hazy2go/gb-link-usb/hw/rev-a/fab/bom_check.txt

BOM check for 5 boards: 27 lines, 57 placed parts, 10 extended parts (feeder fee each), DNP: R1

ok   C15850    base   stock   3657249 need   20  10u                C1,C5,C19                                CL21A106KAYNNNE        
ok   C1525     base   stock  22403876 need   60  100n               C2,C8,C10,C11,C12,C13,C14,C15,C16,C17,C1 CL05B104KO5NNNC        
ok   C1548     base   stock   1209694 need   15  15p                C3,C4                                    0402CG150J500NT        
ok   C23733    base   stock   1859380 need   15  4.7u               C6,C7                                    CL05A475MP5NRNC        
ok   C23733    base   stock   1859380 need   10  4.7u               C9                                       CL05A475MP5NRNC        
ok   C1525     base   stock  22403876 need   35  100n               C101,C102,C103,C104,C105,C106            CL05B104KO5NNNC        
ok   C1546     base   stock   3945135 need   15  100p               C107,C108                                0402CG101J500NT        
ok   C2297     base   stock   2716005 need   10  green              D101                                     KT-0805G               
ok   C165948   expand stock    379998 need   10  TYPE-C-31-M-12     J101                                     TYPE-C-31-M-12         
FAIL C42411119 expand stock         9 need   10  AOTA-B201610S3R3-1 L1                                       AOTA-B201610S3R3-101-T STOCK 9 < 10
ok   C11702    base   stock  14390861 need   20  1k                 R2,R4,R6                                 0402WGF1001TCE         
ok   C25105    base   stock   1423784 need   10  33                 R3                                       0402WGF330JTCE         
ok   C25100    expand stock     33133 need   15  27                 R7,R8                                    0402WGF270JTCE         
ok   C17168    base   stock   9266226 need   10  0                  R10                                      0402WGF0000TCE         
ok   C25905    base   stock   5299091 need   15  5.1k               R101,R102                                0402WGF5101TCE         
ok   C25741    base   stock   9728792 need   20  100k               R103,R107,R108                           0402WGF1003TCE         
ok   C25091    base   stock   1296840 need   15  220                R104,R105                                0402WGF2200TCE         
ok   C11702    base   stock  14390861 need   10  1k                 R106                                     0402WGF1001TCE         
ok   C25076    base   stock   8294192 need   10  100                R109                                     0402WGF1000TCE         
ok   C115360   expand stock     33840 need   15  SKRPABE010         SW1,SW2                                  SKRPABE010             
ok   C42411118 expand stock      6312 need   10  RP2350A            U1                                       RP2350A                
ok   C26537    expand stock     61140 need   10  NCP1117ST33T3G     U2                                       NCP1117ST33T3G         
ok   C97521    base   stock     66926 need   10  W25Q128JVSIQ       U3                                       W25Q128JVSIQ           
ok   C7519     expand stock     48218 need   10  USBLC6-2SC6        U101                                     USBLC6-2SC6            
ok   C7843     expand stock    348745 need   20  SN74LVC1T45DBVR    U102,U103,U104                           SN74LVC1T45DBVR        
ok   C138714   expand stock    247062 need   10  TPD4E05U06DQAR     U105                                     TPD4E05U06DQAR         
ok   C20625731 expand stock      6186 need   10  ABM8-272-T3        X1                                       ABM8-272-T3            

RESULT: 1 FAIL
