hazy2go/gb-link-usb/hw/rev-a/fab/gb-link-usb-BOM-JLC.csv

Comment | Designator | Footprint | LCSC Part #
10u | C1,C5,C19 | generic_capc2012x125 | C15850
100n | C2,C8,C10,C11,C12,C13,C14,C15,C16,C17,C18 | generic_capc1005x50 | C1525
15p | C3,C4 | generic_capc1005x50 | C1548
4.7u | C6,C7 | generic_capc1005x50_wide | C23733
4.7u | C9 | generic_capc1005x50 | C23733
100n | C101,C102,C103,C104,C105,C106 | C_0402_1005Metric | C1525
green | D101 | LED_0805_2012Metric | C2297
TYPE-C-31-M-12 | J101 | USB_C_Receptacle_HRO_TYPE-C-31-M-12 | C165948
AOTA-B201610S3R3-101-T | L1 | abracon_aota-b201610s3r3-101-t | C42411119
1k | R2,R4,R6 | generic_resc1005x35 | C11702
33 | R3 | generic_resc1005x35 | C25105
27 | R7,R8 | generic_resc1005x35 | C25100
0 | R10 | generic_resc1005x35 | C17168
5.1k | R101,R102 | R_0402_1005Metric | C25905
100k | R103,R107,R108 | R_0402_1005Metric | C25741
33 | R104,R105,R106 | R_0402_1005Metric | C25105
100 | R109 | R_0402_1005Metric | C25076
SKRPABE010 | SW1,SW2 | wurthelek_434133025816 | C115360
RP2350A | U1 | rpi_rp2350a_vias | C42411118
NCP1117ST33T3G | U2 | onsemi_ncp1117st33t3g | C26537
W25Q128JVSIQ | U3 | generic_soic127p790x195-8 | C97521
USBLC6-2SC6 | U101 | SOT-23-6 | C7519
SN74LVC1T45DBVR | U102,U103,U104 | SOT-23-6 | C7843
TPD4E05U06DQAR | U105 | USON-10_2.5x1.0mm_P0.5mm | C138714
ABM8-272-T3 | X1 | generic_xtalcc320x250x80-4 | C20625731
