hazy2go/gb-link-usb/hw/case/tray.stl

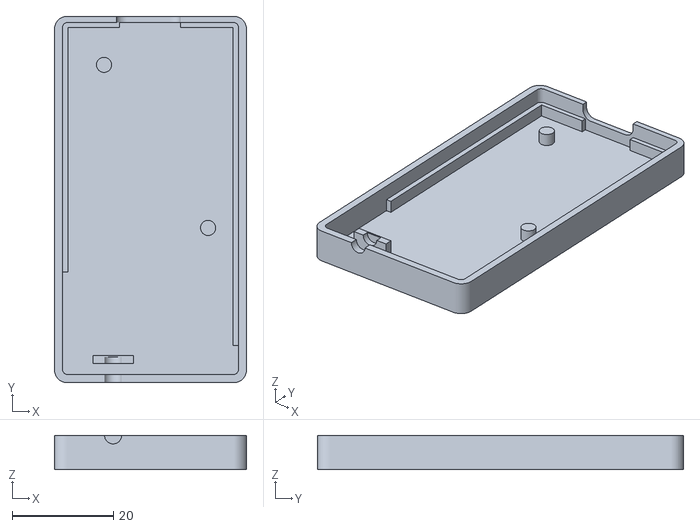
[picture p8: CAD file, 2026-10-15]
hw/case/tray.stl
38.0 x 72.5 x 6.80
