hazy2go/gb-link-usb/hw/case/parts.scad

module parts_top() {
  // generated by check_fit.py: every top part as a box (courtyard x height), board-local coordinates
  translate([24.720,41.070,0]) cube([2.010,1.260,1.300]); // C5
  translate([9.710,29.045,0]) cube([1.010,0.510,0.500]); // C15
  translate([12.380,47.615,0]) cube([1.010,0.510,0.500]); // C2
  translate([21.445,44.095,0]) cube([6.510,7.260,1.800]); // U2
  translate([5.795,40.780,0]) cube([7.910,5.290,2.000]); // U3
  translate([14.345,37.595,0]) cube([0.510,1.010,0.500]); // C12
  translate([23.280,30.045,0]) cube([1.010,0.510,0.500]); // C14
  translate([21.880,26.445,0]) cube([1.010,0.510,0.500]); // C16
  translate([15.345,37.595,0]) cube([0.510,1.010,0.350]); // R7
  translate([23.633,53.570,0]) cube([2.010,1.260,1.300]); // C1
  translate([9.710,33.845,0]) cube([1.010,0.510,0.500]); // C13
  translate([16.345,37.595,0]) cube([0.510,1.010,0.350]); // R8
  translate([22.680,33.445,0]) cube([1.010,0.510,0.500]); // C17
  translate([0.810,52.070,0]) cube([2.010,1.260,1.300]); // C19
  translate([18.195,35.995,0]) cube([1.010,0.510,0.500]); // C7
  translate([17.595,36.995,0]) cube([2.210,1.810,1.000]); // L1
  translate([20.645,35.245,0]) cube([0.510,1.010,0.500]); // C9
  translate([31.845,21.095,0]) cube([0.510,1.010,0.350]); // R4
  translate([3.725,21.285,0]) cube([1.950,1.030,0.350]); // R105
  translate([6.295,53.195,0]) cube([3.210,4.610,2.500]); // SW1
  translate([29.175,27.705,0]) cube([3.450,1.990,1.100]); // D101
  translate([3.725,19.885,0]) cube([1.950,1.030,0.350]); // R108
  translate([11.185,52.325,0]) cube([1.030,1.950,0.350]); // R102
  translate([5.795,14.145,0]) cube([1.010,1.910,0.500]); // C106
  translate([7.405,19.155,0]) cube([4.190,3.490,1.550]); // U103
  translate([7.405,24.155,0]) cube([4.190,3.490,1.550]); // U102
  translate([7.405,14.155,0]) cube([4.190,3.490,1.550]); // U104
  translate([3.725,16.285,0]) cube([1.950,1.030,0.350]); // R106
  translate([0.205,1.555,0]) cube([19.040,11.940,0.050]); // J102
  translate([20.645,37.095,0]) cube([0.510,1.010,0.350]); // R3
  translate([15.095,17.045,0]) cube([3.210,2.510,0.800]); // X1
  translate([6.145,22.895,0]) cube([1.910,1.010,0.500]); // C102
  translate([16.045,23.295,0]) cube([0.510,1.010,0.350]); // R2
  translate([12.195,14.545,0]) cube([1.010,1.910,0.500]); // C105
  translate([17.245,23.315,0]) cube([0.510,1.010,0.500]); // C10
  translate([6.145,17.895,0]) cube([1.910,1.010,0.500]); // C104
  translate([3.725,26.285,0]) cube([1.950,1.030,0.350]); // R104
  translate([14.795,21.445,0]) cube([1.010,0.510,0.500]); // C3
  translate([10.185,52.325,0]) cube([1.030,1.950,0.350]); // R101
  translate([9.745,22.895,0]) cube([1.910,1.010,0.500]); // C101
  translate([6.295,27.045,0]) cube([1.010,1.910,0.500]); // C107
  translate([13.195,27.195,0]) cube([7.010,7.010,0.860]); // U1
  translate([9.715,31.445,0]) cube([1.010,0.510,0.500]); // C8
  translate([26.325,28.185,0]) cube([1.950,1.030,0.350]); // R109
  translate([5.095,47.745,0]) cube([1.010,0.510,0.350]); // R10
  translate([5.095,49.145,0]) cube([1.010,0.510,0.350]); // R6
  translate([1.345,19.155,0]) cube([1.910,3.090,0.530]); // U105
  translate([14.645,24.115,0]) cube([0.510,1.010,0.500]); // C18
  translate([3.725,24.885,0]) cube([1.950,1.030,0.350]); // R107
  translate([6.085,24.925,0]) cube([1.030,1.950,0.350]); // R103
  translate([12.955,49.905,0]) cube([3.490,4.190,1.550]); // U101
  translate([9.745,17.895,0]) cube([1.910,1.010,0.500]); // C103
  translate([18.195,35.055,0]) cube([1.010,0.510,0.500]); // C6
  translate([26.195,21.620,0]) cube([4.610,3.210,2.500]); // SW2
  translate([11.335,54.735,0]) cube([10.730,9.510,3.250]); // J101
  translate([23.275,31.045,0]) cube([1.010,0.510,0.500]); // C11
  translate([17.775,21.445,0]) cube([1.010,0.510,0.500]); // C4
  translate([6.095,20.545,0]) cube([1.010,1.910,0.500]); // C108
}
