hazy2go/gb-link-usb/hw/case/assembly.png

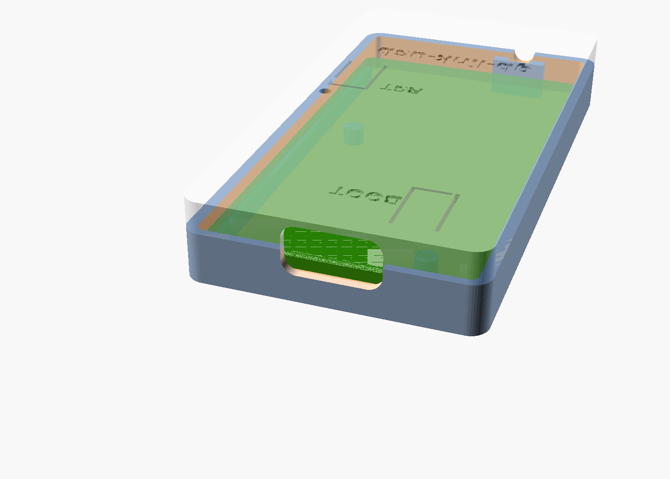
hw/case/assembly.png
