hazy2go/gb-link-usb/hw/rev-a/gb-link-usb-schematic.pdf

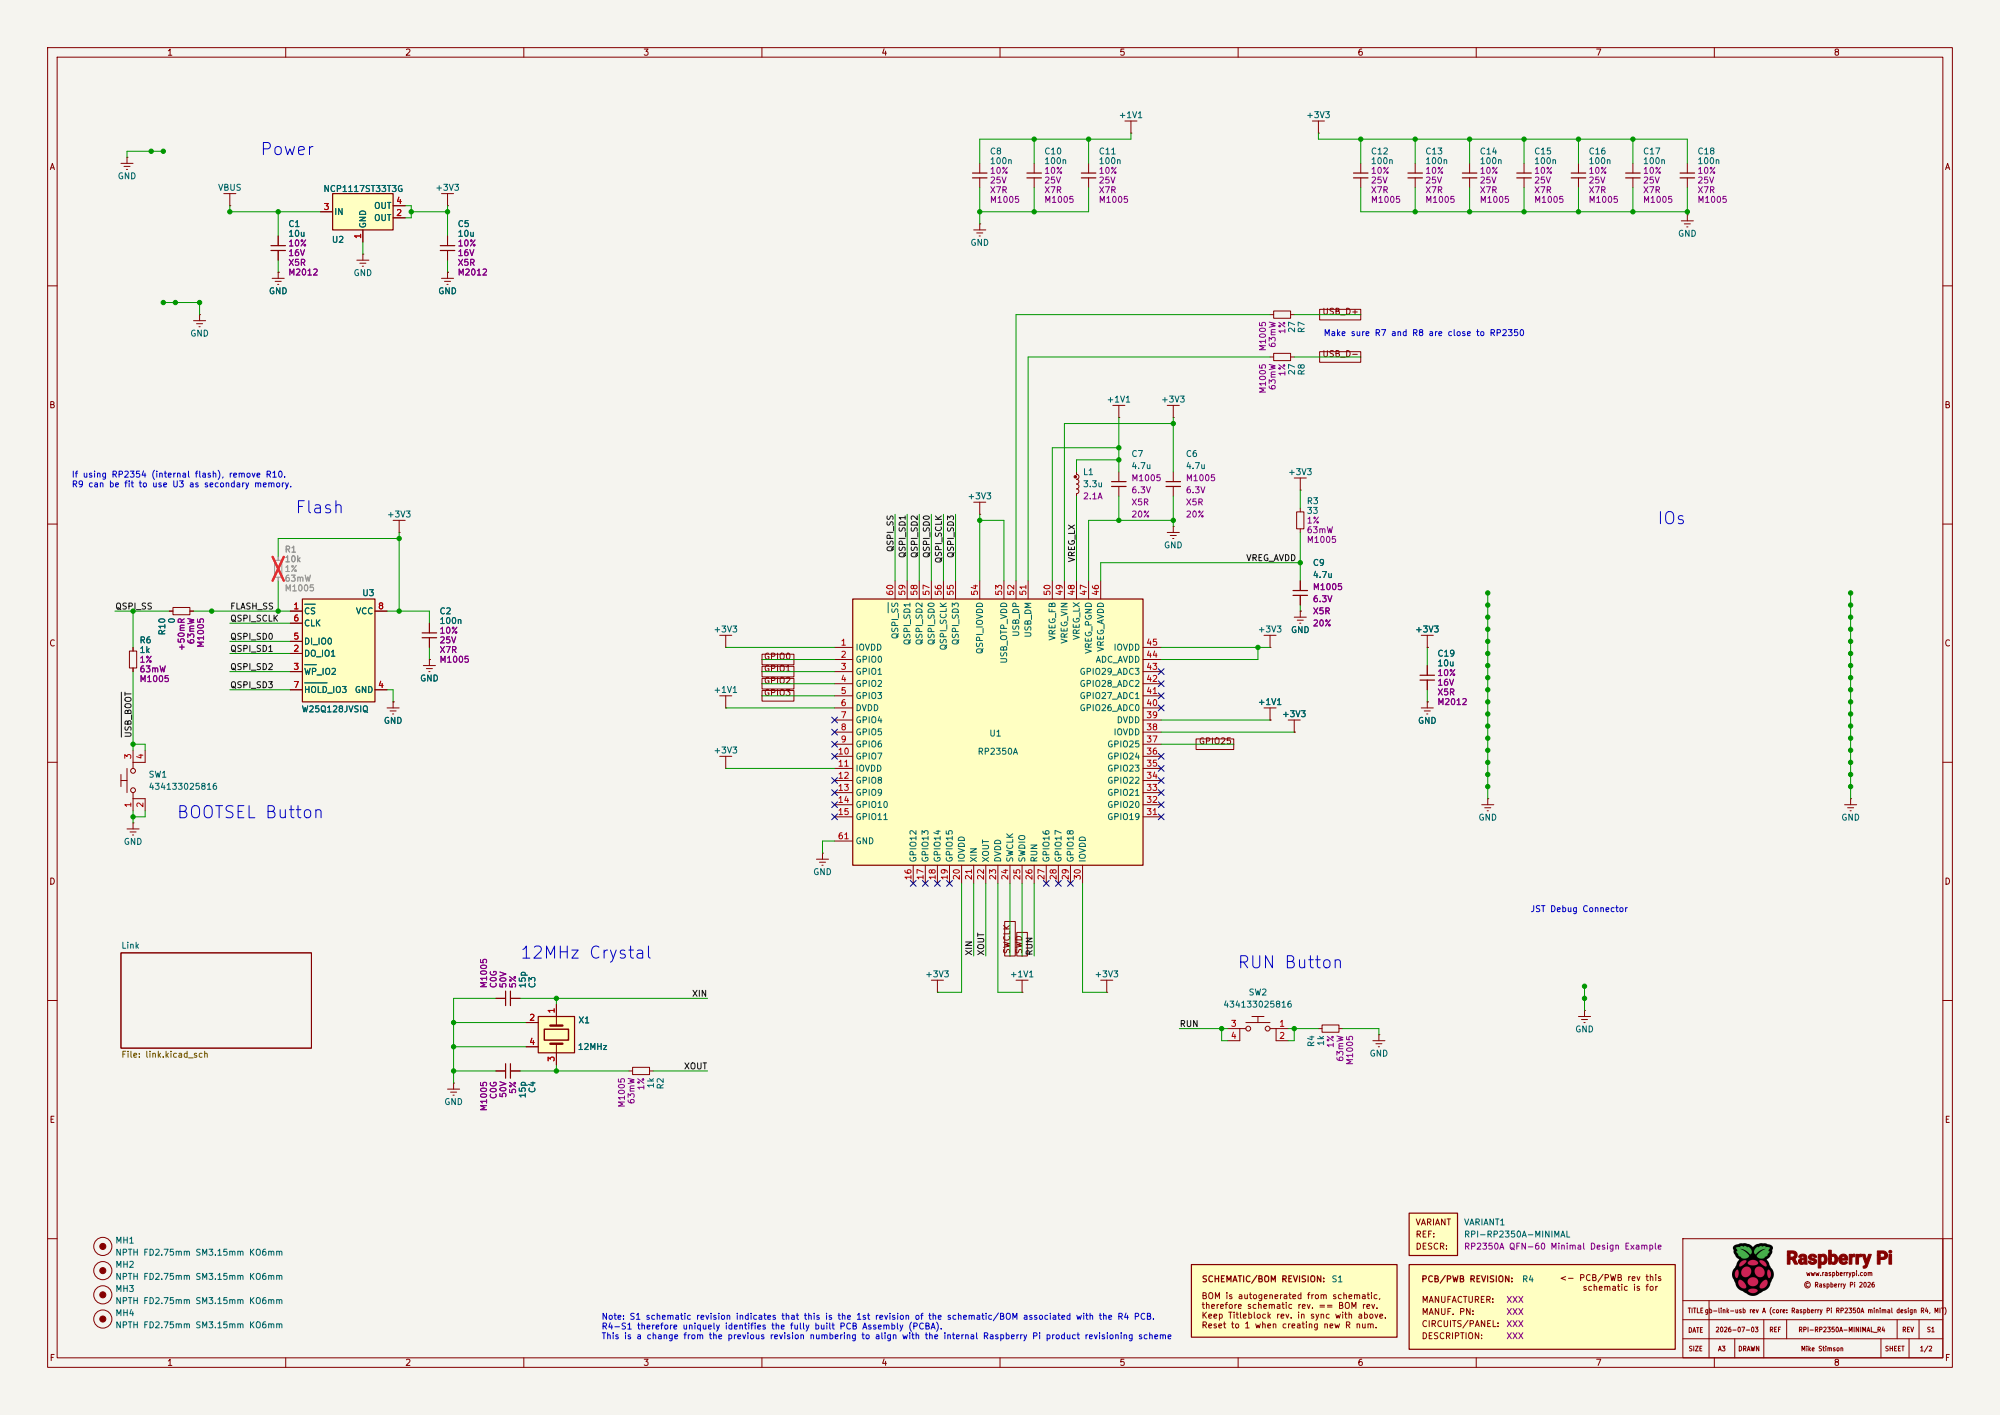
[picture p10: page 1]

Make sure R7 and R8 are close to RP2350 Power

If using RP2354 (internal flash), remove R10. R9 can be fit to use U3 as secondary memory.

JST Debug Connector BOOTSEL Button

TITLE gb-link-usb rev A (core: Raspberry Pi RP2350A minimal design R4, MIT) DATE | DRAWN 2026-07-03 | S1

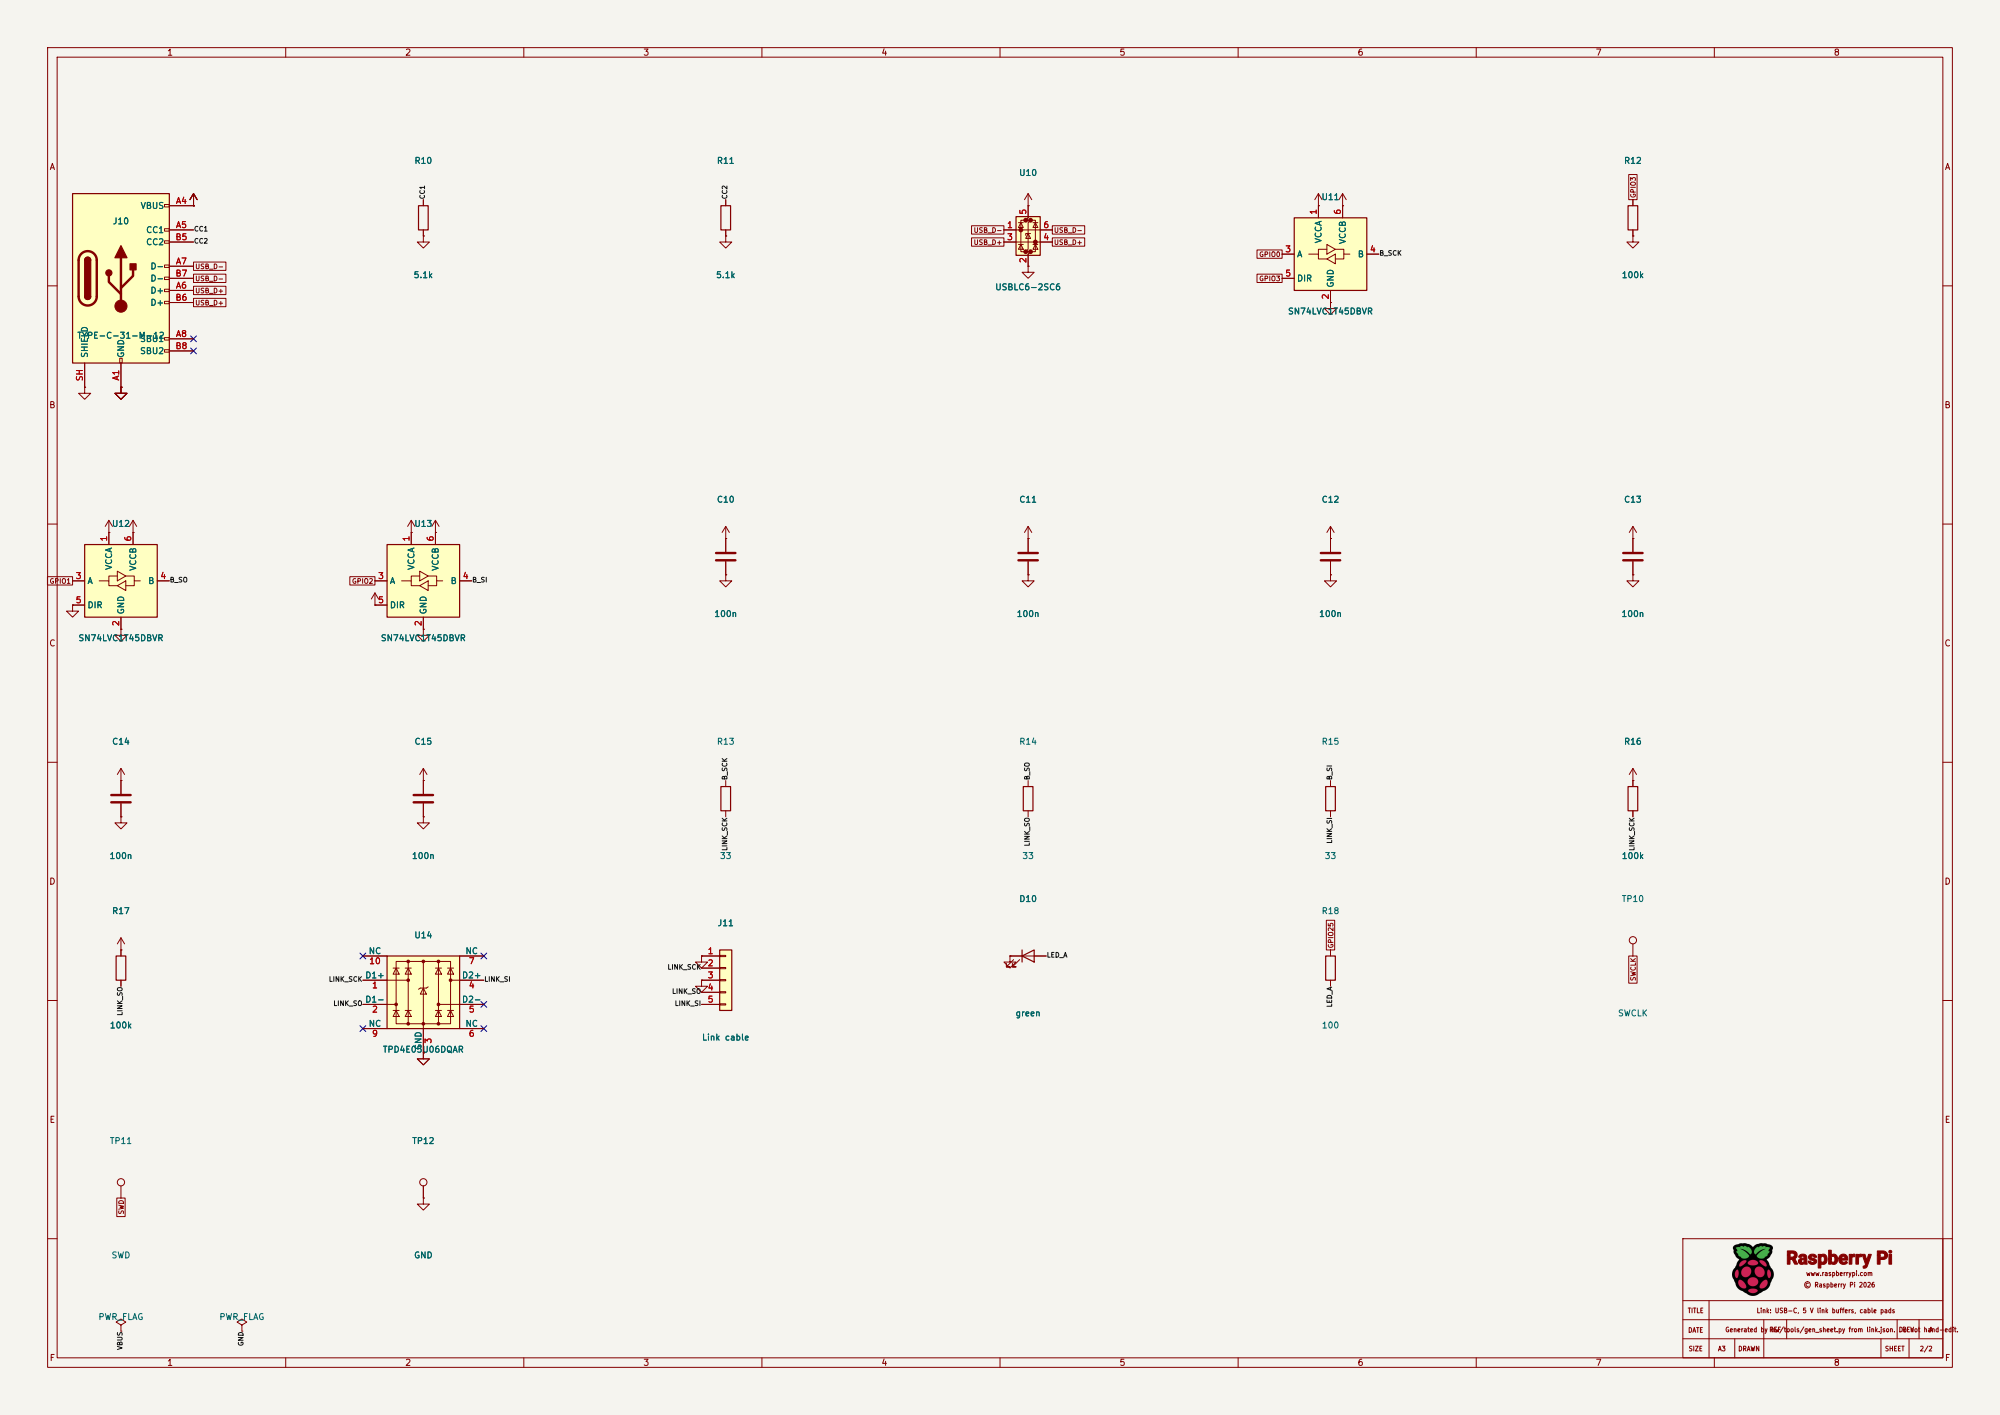
[picture p11: page 2]

TITLE | DRAWN Link: USB-C, 5 V link buffers, cable pads DATE
