hazy2go/gb-link-usb/hw/rev-a/gb-link-usb.kicad_pcb

## KiCad design hw/rev-a/gb-link-usb.kicad_pcb (2026-10-15)

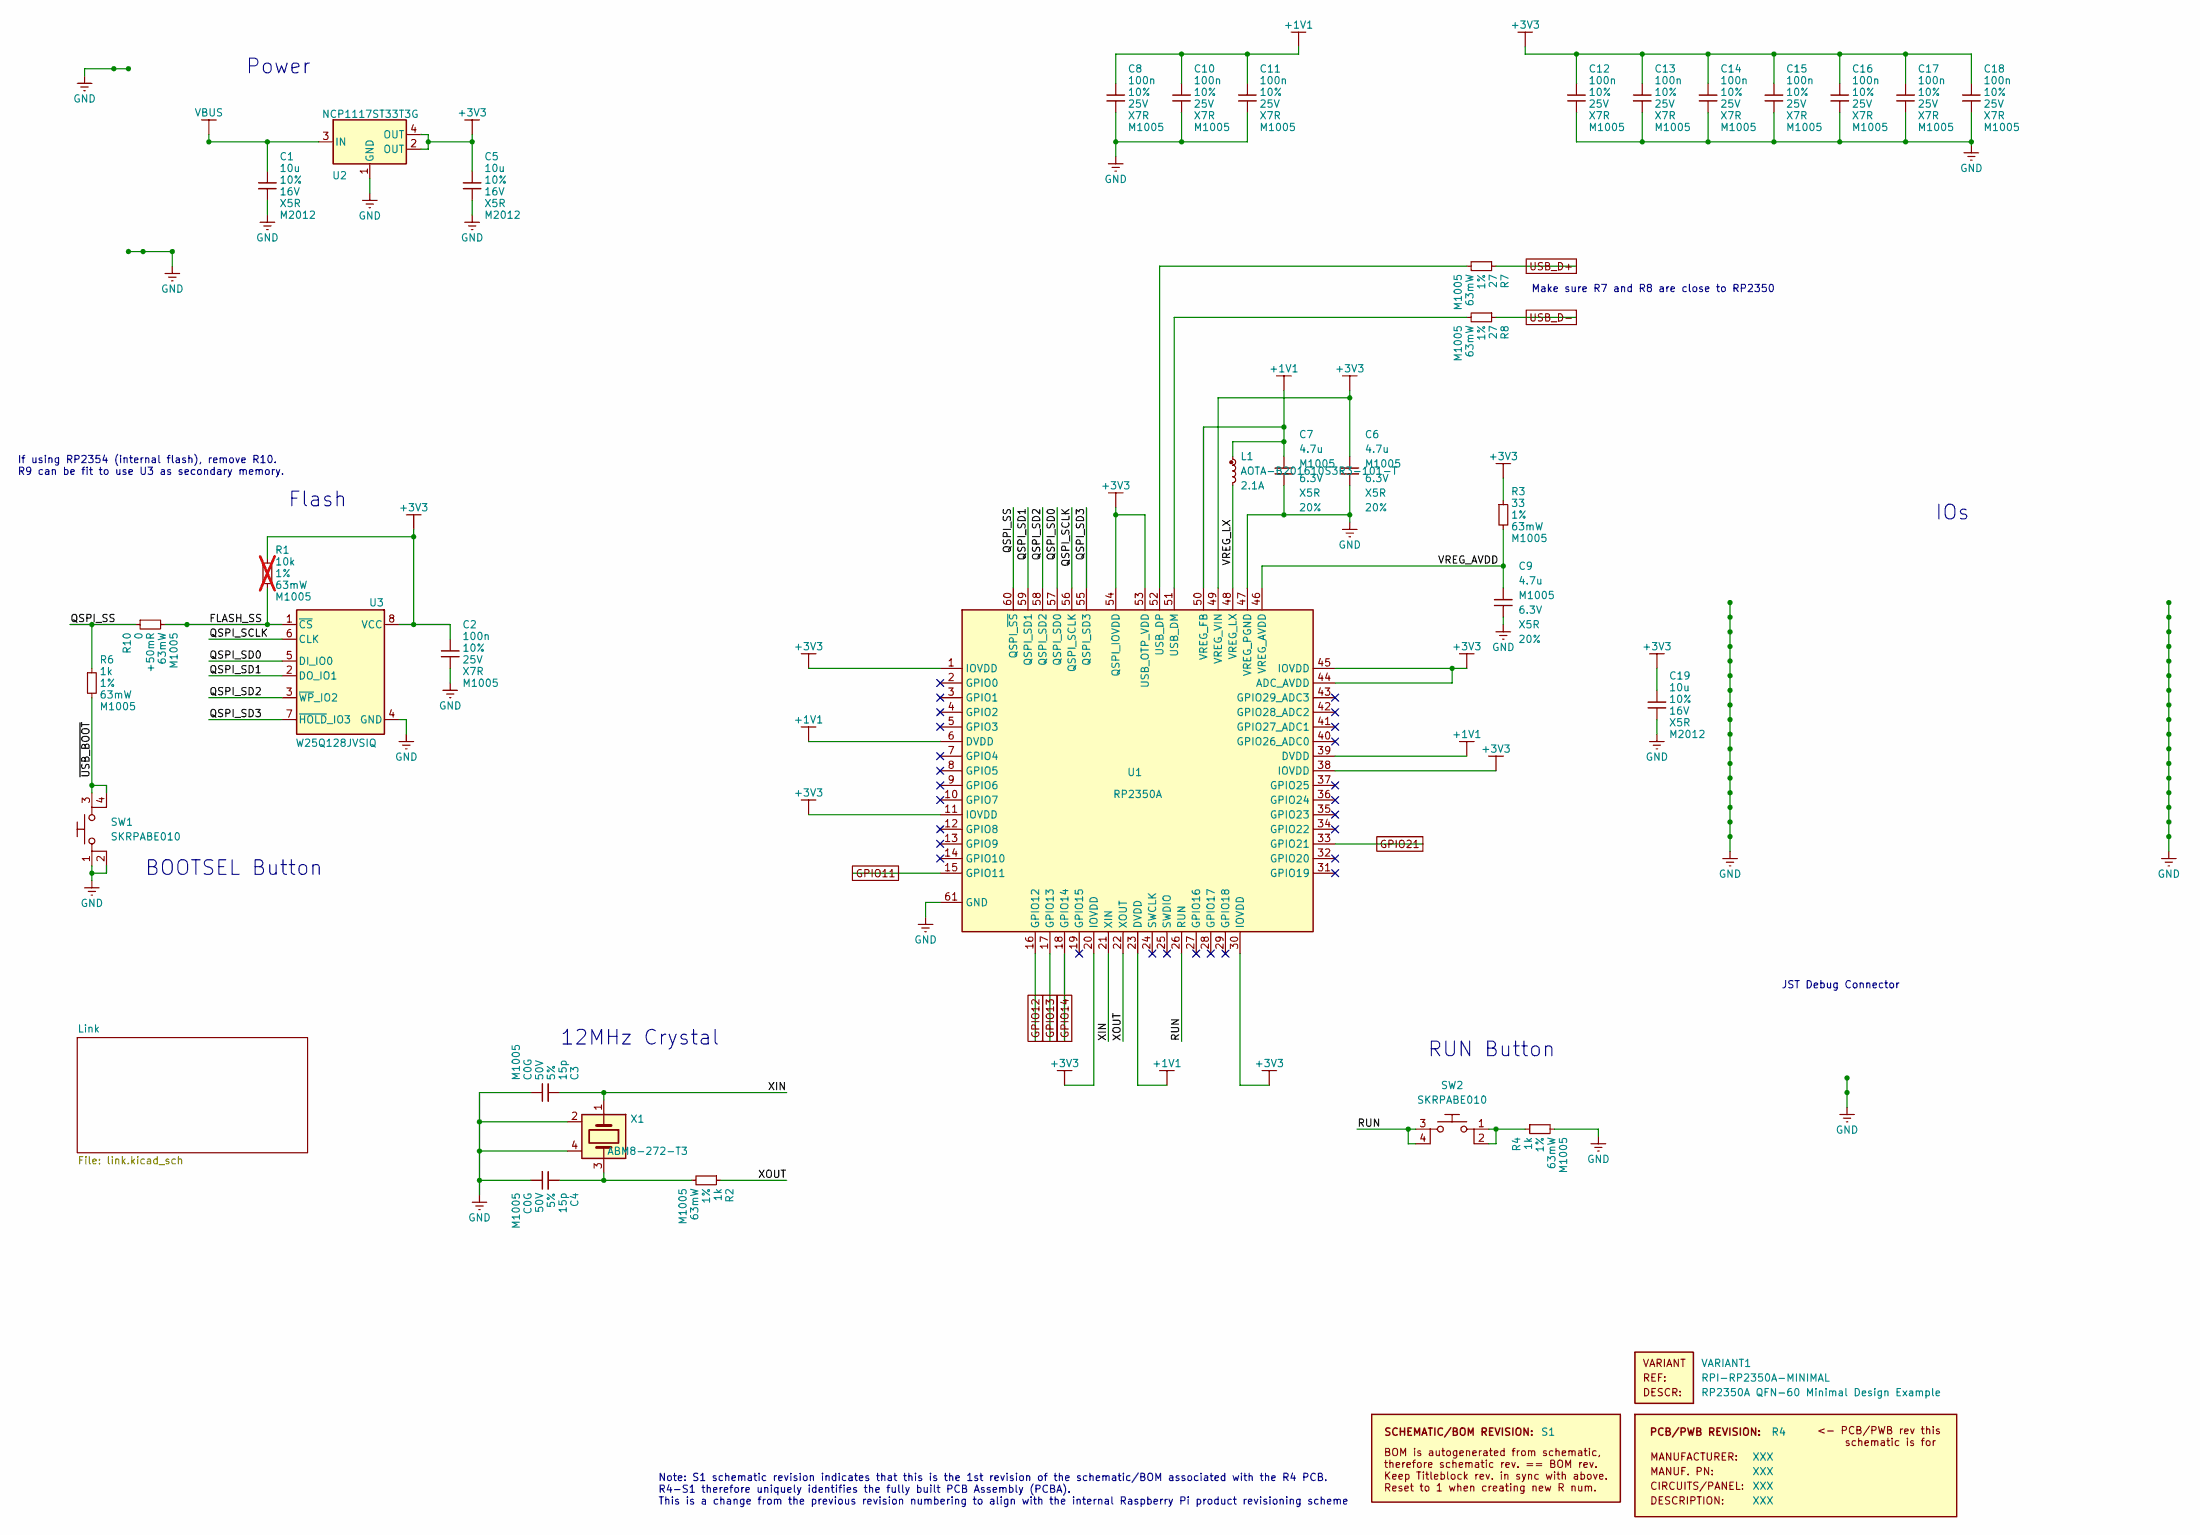
[picture p12: schematic gb-link-usb.kicad_sch, gb-link-usb rev A (core: Raspberry Pi RP2350A minimal desig…]

Parts:
C1, C5, C19: 10u; generic_capc2012x125; voltage 16V; tolerance 10%; part_uid RP-01GYSK-AVBE41; LCSC C15850
C2, C8, C10, C11, C12, C13, C14, C15, C16, C17, C18: 100n; generic_capc1005x50; voltage 25V; tolerance 10%; part_uid RP-01BJ9Y-KRGF41; LCSC C1525
C3, C4: 15p; generic_capc1005x50; voltage 50V; tolerance 5%; part_uid RP-01C89W-LLY9XV; LCSC C1548
C6, C7: 4.7u; generic_capc1005x50_wide; voltage 6.3V; tolerance 20%; part_uid RP-019A1P-0C2GHY; LCSC C23733
C9: 4.7u; generic_capc1005x50; voltage 6.3V; tolerance 20%; part_uid RP-019A1P-0C2GHY; LCSC C23733
L1: AOTA-B201610S3R3-101-T; abracon_aota-b201610s3r3-101-t; tolerance 20%; part_uid RP-01GY5D-2VC7WP; LCSC C42411119
PCB1: R4; manufacturer_pn XXX
R1: 10k; generic_resc1005x35; tolerance 1%; voltage 50V; part_uid RP-019A1P-53DHSX; LCSC C25744; not fitted
R2, R4, R6: 1k; generic_resc1005x35; tolerance 1%; voltage 50V; part_uid RP-019A1P-4Z6ZWY; LCSC C11702
R3: 33; generic_resc1005x35; tolerance 1%; voltage 50V; part_uid RP-019A1P-58PW9L; LCSC C25105
R7, R8: 27; generic_resc1005x35; tolerance 1%; voltage 50V; part_uid RP-01C89V-LTEYC4; LCSC C25100
R10: 0; generic_resc1005x35; tolerance +50mR; voltage 50V; part_uid RP-019A1P-4Y4V63; LCSC C17168
SBREV1: S1
SW1, SW2: SKRPABE010; wurthelek_434133025816; part_uid RP-01H0MT-6E9H8F; LCSC C115360
U1: RP2350A; rpi_rp2350a_vias; part_uid RP-01HA9H-9K5E8T; LCSC C42411118
U2: NCP1117ST33T3G; onsemi_ncp1117st33t3g; voltage 3.3V; part_uid RP-01JWD9-7JRX6J; LCSC C26537
U3: W25Q128JVSIQ; generic_soic127p790x195-8; voltage 2.7-3.6V; part_uid RP-01JWD4-F1H4N9; LCSC C97521
VARIANT1: RPI-RP2350A-MINIMAL
X1: ABM8-272-T3; generic_xtalcc320x250x80-4; tolerance 30ppm; part_uid RP-01G8X7-GS352B; LCSC C20625731

Connections:
+1V1: C7.1, C8.1, C10.1, C11.1, L1.1, U1.6 (DVDD), U1.23 (DVDD), U1.39 (DVDD), U1.50 (VREG_FB)
+3V3: C2.1, C5.1, C6.1, C12.1, C13.1, C14.1, C15.1, C16.1, C17.1, C18.1, C19.1, R1.1, R3.1, U1.1 (IOVDD), U1.11 (IOVDD), U1.20 (IOVDD), U1.30 (IOVDD), U1.38 (IOVDD), U1.44 (ADC_AVDD), U1.45 (IOVDD), U1.49 (VREG_VIN), U1.53 (USB_OTP_VDD), U1.54 (QSPI_IOVDD), U2.2 (OUT), U2.4 (OUT), U3.8 (VCC); also elsewhere on the board
/FLASH_SS: R1.2, R10.2, U3.1 (~CS)
/QSPI_SCLK: U1.56 (QSPI_SCLK), U3.6 (CLK)
/QSPI_SD0: U1.57 (QSPI_SD0), U3.5 (DI_IO0)
/QSPI_SD1: U1.59 (QSPI_SD1), U3.2 (DO_IO1)
/QSPI_SD2: U1.58 (QSPI_SD2), U3.3 (~WP_IO2)
/QSPI_SD3: U1.55 (QSPI_SD3), U3.7 (~HOLD_IO3)
/QSPI_SS: R6.1, R10.1, U1.60 (QSPI_~SS)
/RUN: SW2.3, SW2.4, U1.26 (RUN)
/VREG_AVDD: C9.1, R3.2, U1.46 (VREG_AVDD)
/VREG_LX: L1.2, U1.48 (VREG_LX)
/XIN: C3.1, U1.21 (XIN), X1.1
/XOUT: R2.1, U1.22 (XOUT)
/~USB_BOOT: R6.2, SW1.3, SW1.4
GND: C1.2, C2.2, C3.2, C4.2, C5.2, C6.2, C7.2, C8.2, C9.2, C10.2, C11.2, C12.2, C13.2, C14.2, C15.2, C16.2, C17.2, C18.2, C19.2, R4.2, SW1.1, SW1.2, U1.47 (VREG_PGND), U1.61 (GND), U2.1 (GND), U3.4 (GND), X1.2, X1.4; also elsewhere on the board
GPIO11: U1.15 (GPIO11); also elsewhere on the board
GPIO12: U1.16 (GPIO12); also elsewhere on the board
GPIO13: U1.17 (GPIO13); also elsewhere on the board
GPIO14: U1.18 (GPIO14); also elsewhere on the board
GPIO21: U1.33 (GPIO21); also elsewhere on the board
unnamed: C4.1, R2.2, X1.3
unnamed: R4.1, SW2.1, SW2.2
unnamed: R8.2, U1.51 (USB_DM)
unnamed: R7.2, U1.52 (USB_DP)
USB_D+: R7.1; also elsewhere on the board
USB_D-: R8.1; also elsewhere on the board
VBUS: C1.1, U2.3 (IN); also elsewhere on the board

Notes on the sheet:
JST Debug Connector
IOs
RUN Button
BOOTSEL Button
If using RP2354 (internal flash), remove R10. R9 can be fit to use U3 as secondary memory.
Flash
Note: S1 schematic revision indicates that this is the 1st revision of the schematic/BOM associated with the R4 PCB. R4-S1 therefore uniquely identifies the fully built PCB Assembly (PCBA). This is a change from the previous revision numbering to align with the internal Raspberry Pi product revisio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
Make sure R7 and R8 are close to RP2350
12MHz Crystal
Power

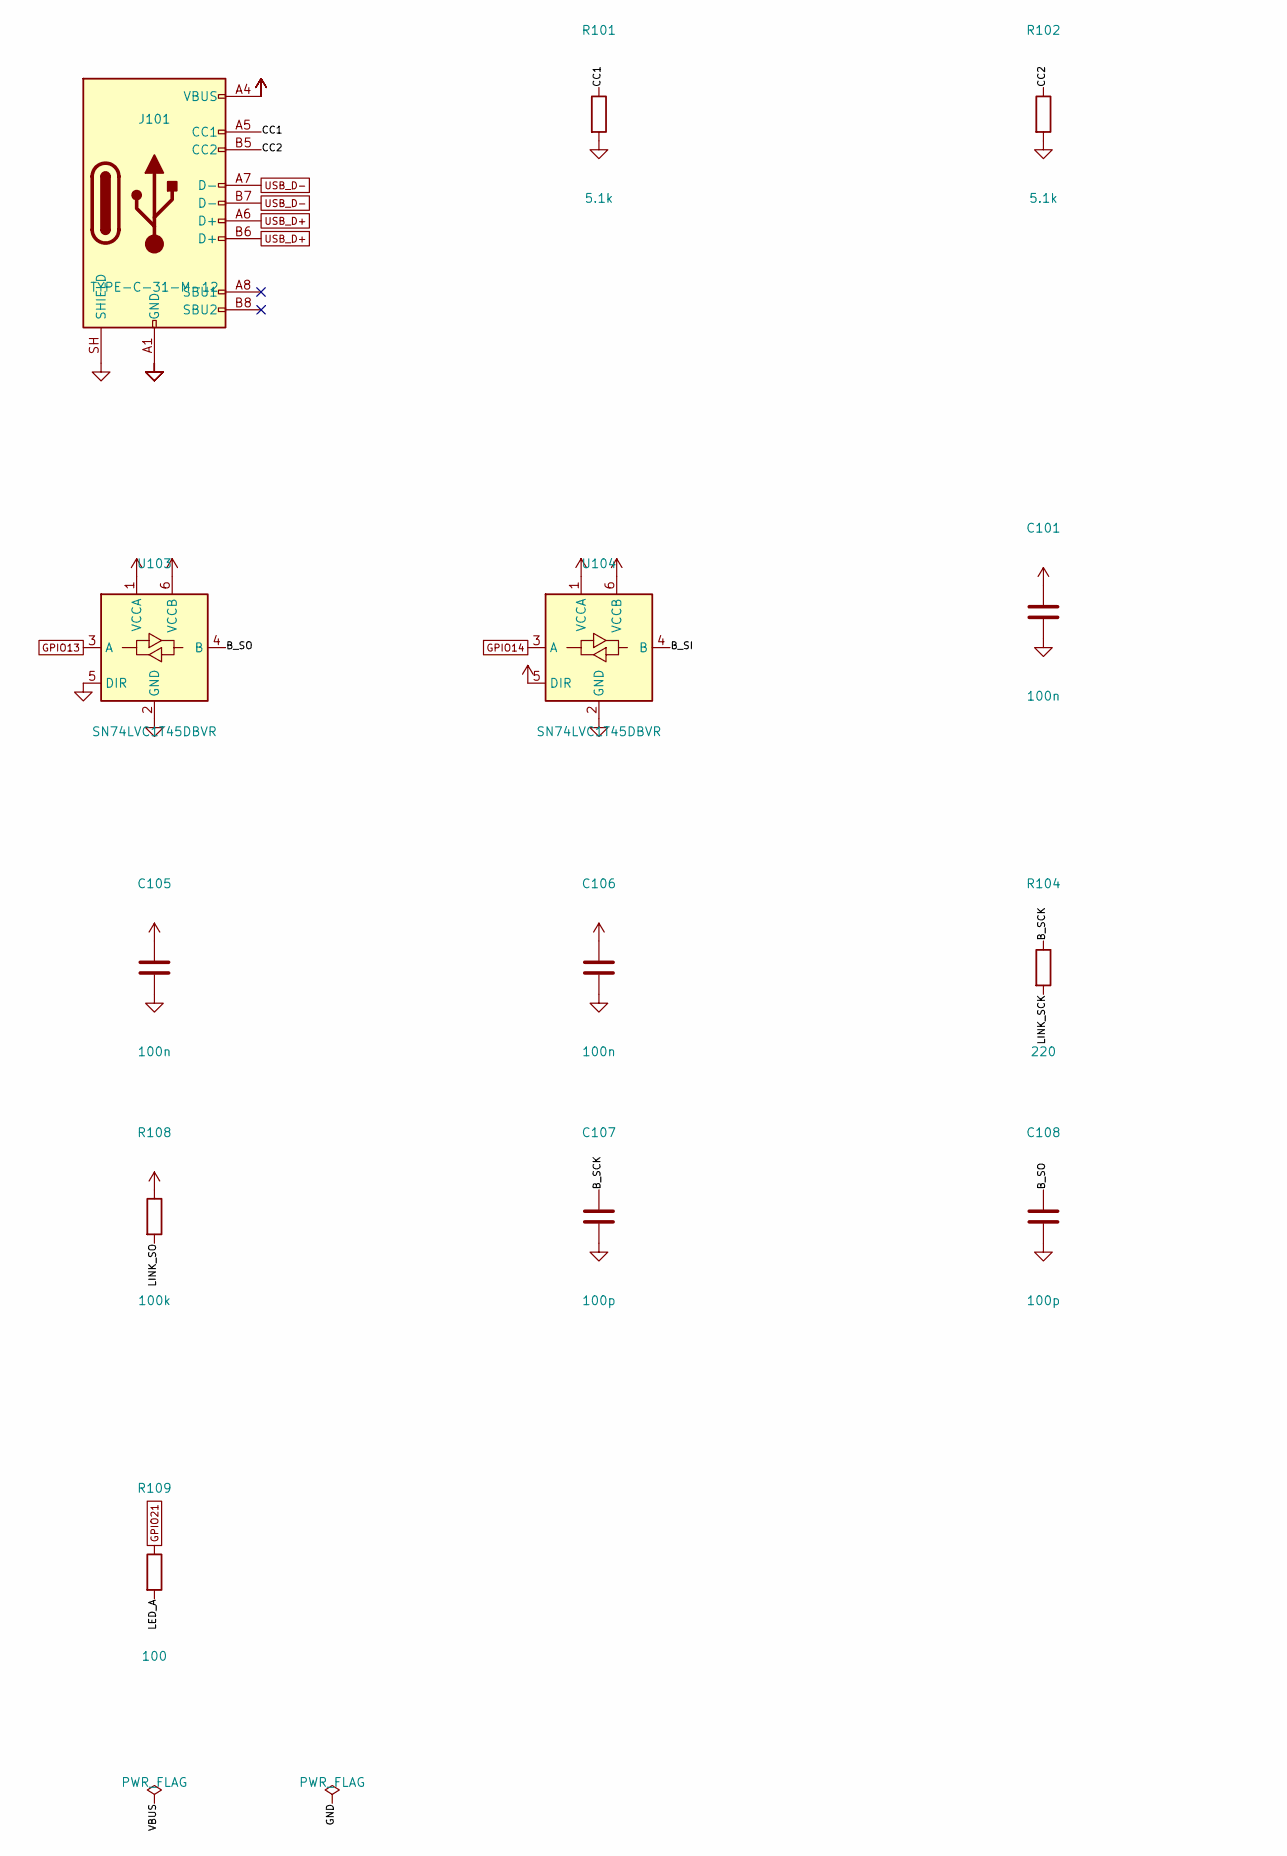
[picture p13: schematic link.kicad_sch, Link: USB-C, 5 V link buffers, cable pads, part in row 1, column 1]

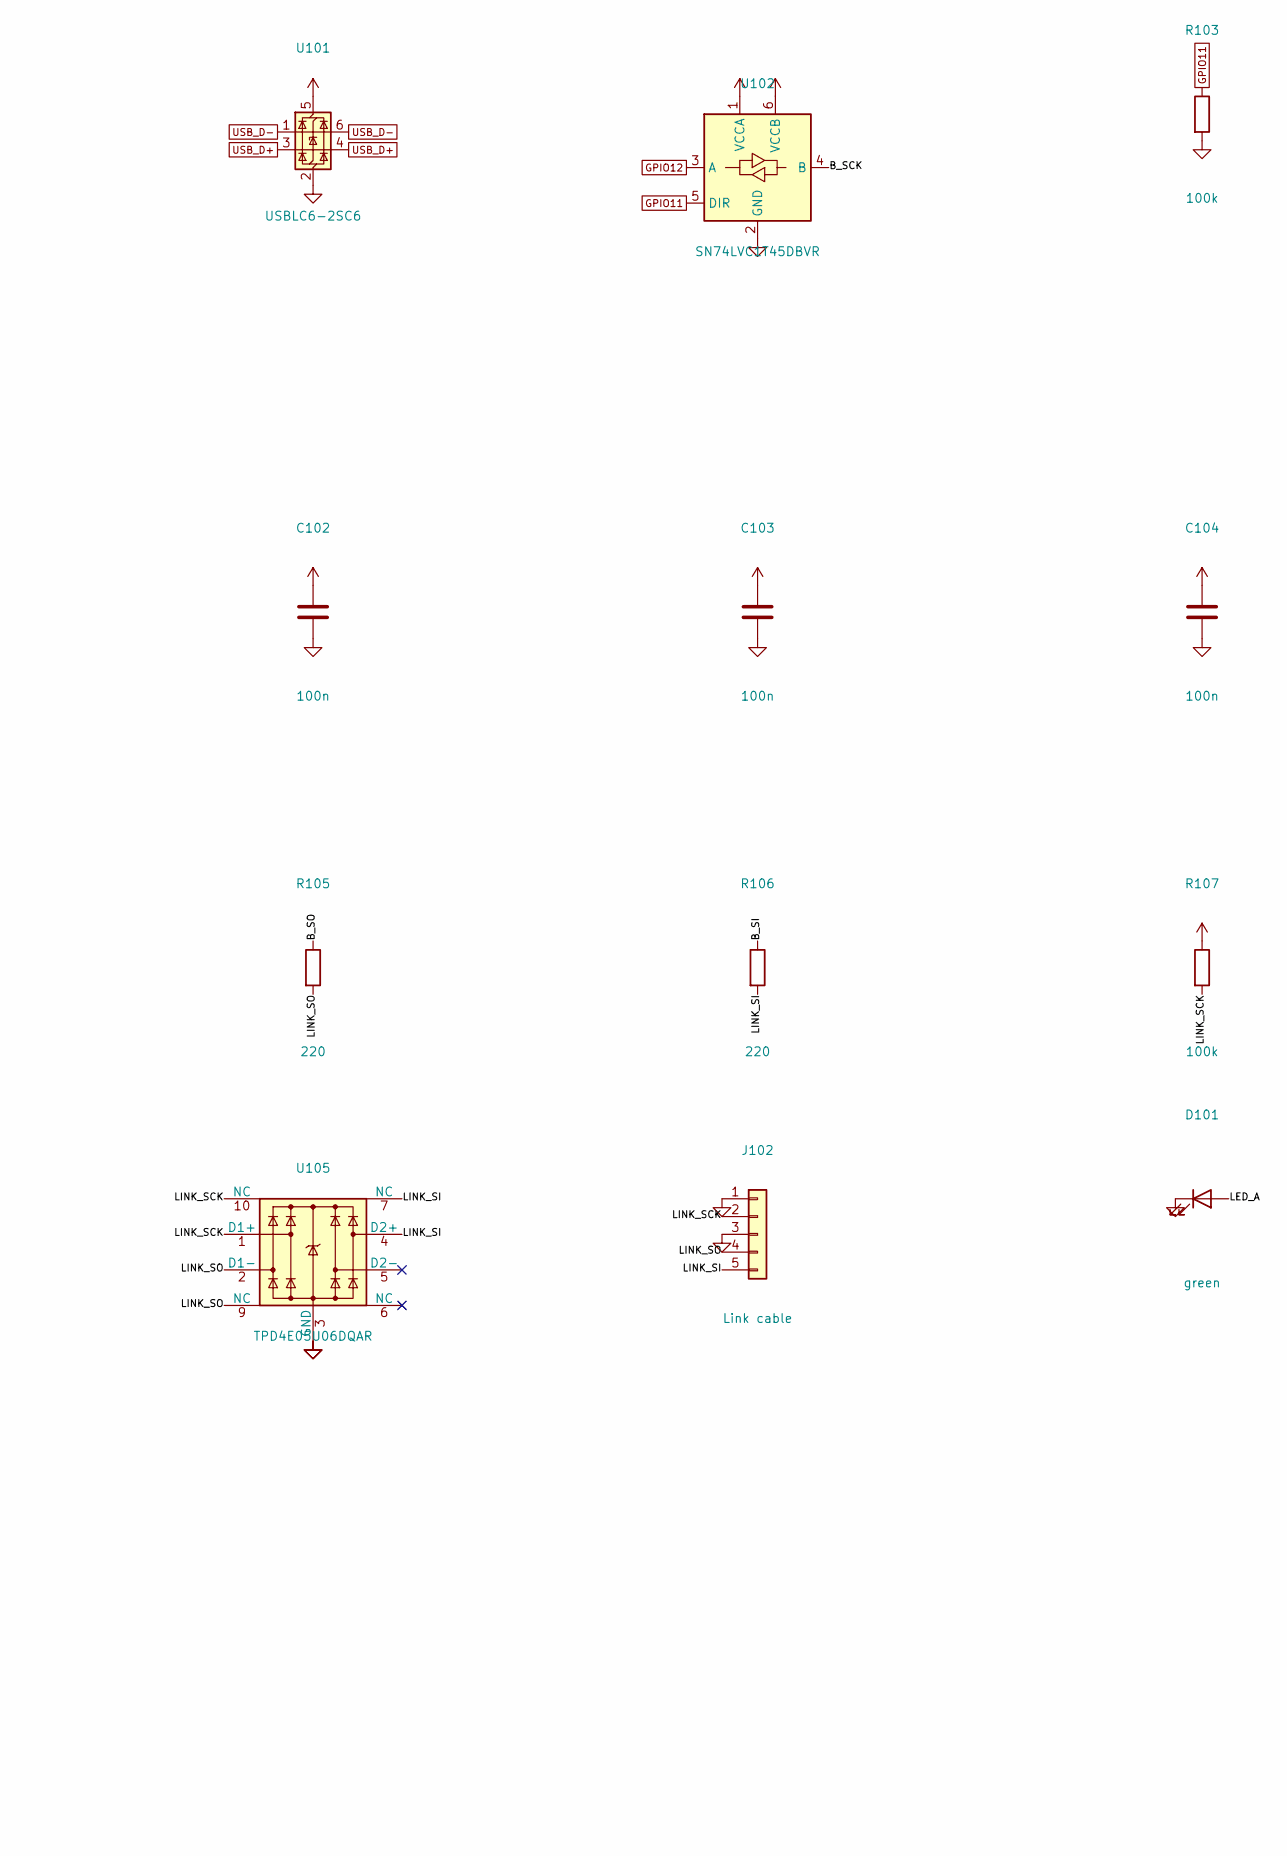
[picture p14: schematic link.kicad_sch, Link: USB-C, 5 V link buffers, cable pads, part in row 1, column 2]

Parts:
C101, C102, C103, C104, C105, C106: 100n; C_0402_1005Metric; LCSC C1525
C107, C108: 100p; C_0402_1005Metric; LCSC C1546
D101: green; LED_0805_2012Metric; LCSC C2297
J101: TYPE-C-31-M-12; USB_C_Receptacle_HRO_TYPE-C-31-M-12; LCSC C165948
J102: Link cable; SolderWire-0.15sqmm_1x05_P4mm_D0.5mm_OD1.5mm_Relief
R101, R102: 5.1k; R_0402_1005Metric; LCSC C25905
R103, R107, R108: 100k; R_0402_1005Metric; LCSC C25741
R104, R105, R106: 220; R_0402_1005Metric; LCSC C25091
R109: 100; R_0402_1005Metric; LCSC C25076
U101: USBLC6-2SC6; SOT-23-6; LCSC C7519
U102, U103, U104: SN74LVC1T45DBVR; SOT-23-6; LCSC C7843
U105: TPD4E05U06DQAR; USON-10_2.5x1.0mm_P0.5mm; LCSC C138714

Connections:
+3V3: C101.1, C103.1, C105.1, U102.1 (VCCA), U103.1 (VCCA), U104.1 (VCCA), U104.5 (DIR); also elsewhere on the board
/Link/B_SCK: C107.1, R104.1, U102.4 (B)
/Link/B_SI: R106.1, U104.4 (B)
/Link/B_SO: C108.1, R105.1, U103.4 (B)
/Link/CC1: J101.A5 (CC1), R101.1
/Link/CC2: J101.B5 (CC2), R102.1
/Link/LED_A: D101.2 (A), R109.2
/Link/LINK_SCK: J102.2, R104.2, R107.2, U105.1 (D1+), U105.10 (NC)
/Link/LINK_SI: J102.5, R106.2, U105.4 (D2+), U105.7 (NC)
/Link/LINK_SO: J102.4, R105.2, R108.2, U105.2 (D1-), U105.9 (NC)
GND: C101.2, C102.2, C103.2, C104.2, C105.2, C106.2, C107.2, C108.2, D101.1 (K), J101.A1 (GND), J101.A12 (GND), J101.B1 (GND), J101.B12 (GND), J101.SH (SHIELD), J102.1, J102.3, R101.2, R102.2, R103.2, U101.2 (GND), U102.2 (GND), U103.2 (GND), U103.5 (DIR), U104.2 (GND), U105.3 (GND), U105.8 (GND); also elsewhere on the board
GPIO11: R103.1, U102.5 (DIR); also elsewhere on the board
GPIO12: U102.3 (A); also elsewhere on the board
GPIO13: U103.3 (A); also elsewhere on the board
GPIO14: U104.3 (A); also elsewhere on the board
GPIO21: R109.1; also elsewhere on the board
USB_D+: J101.A6 (D+), J101.B6 (D+), U101.3 (I/O2), U101.4 (I/O2); also elsewhere on the board
USB_D-: J101.A7 (D-), J101.B7 (D-), U101.1 (I/O1), U101.6 (I/O1); also elsewhere on the board
VBUS: C102.1, C104.1, C106.1, J101.A4 (VBUS), J101.A9 (VBUS), J101.B4 (VBUS), J101.B9 (VBUS), R107.1, R108.1, U101.5 (VBUS), U102.6 (VCCB), U103.6 (VCCB), U104.6 (VCCB); also elsewhere on the board

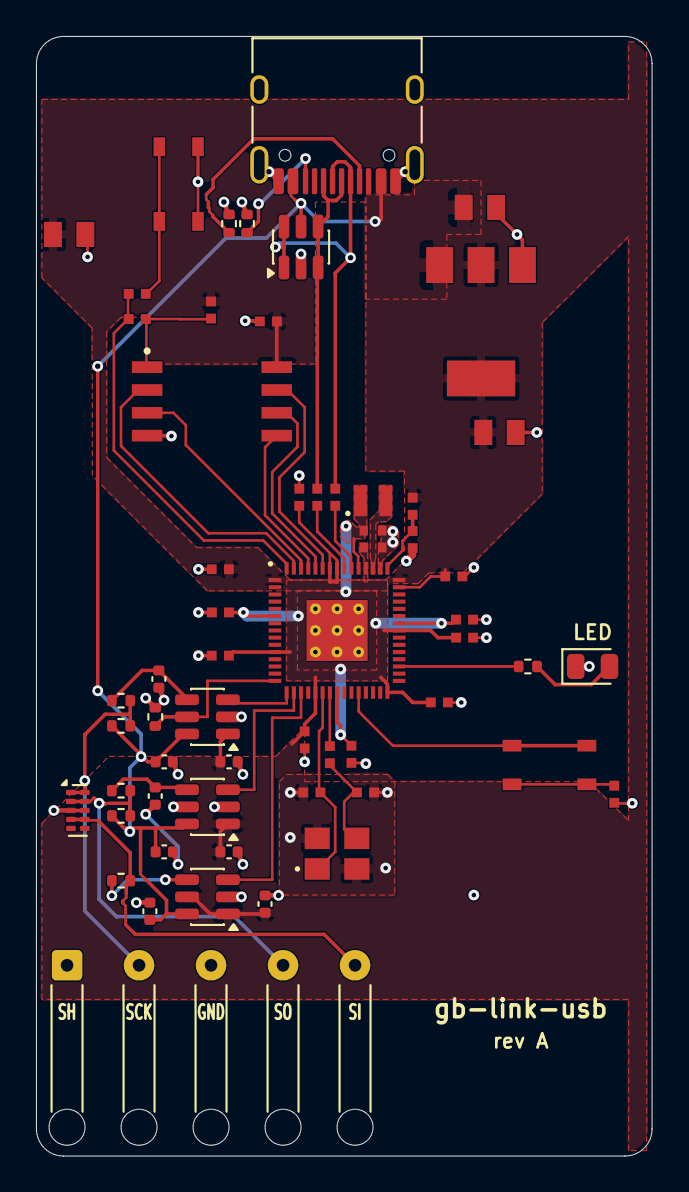
[picture p15: board gb-link-usb.kicad_pcb from above]

Board: 2 copper layers, 34.2 x 62.2 mm, 59 parts (0 on the bottom side), 37 nets.
