hazy2go/gb-link-usb/(commit log)

2026-10-15 Project start: goal, plan, link/printer protocol notes, logbook, handoff
2026-10-15 logbook: cut cable has orange/red/blue/green wires
2026-10-15 PROTOCOL: cable-end pinout from mofosyne, only GND/SCK must be identified
2026-10-15 Web printer decoder + page, toolchain notes
    - web/gbprinter.js: packet parser, checksum, RLE, 2bpp tiles, palette, strip joining
    - web/index.html: hex dump / file input, PNG download, #demo test print
    - 7 Node tests pass (cd web && npm test)
    - PROTOCOL.md: RLE, tile format, palette (verify), checksum quote
    - LOGBOOK: decoder and toolchain install (Arm GCC 15.3, Pico SDK 2.3.1)
2026-10-15 logbook: cut cable has a bare shield around the 4 wires
2026-10-15 logbook: cut DMG-04 pin mapping (multimeter)
2026-10-15 logbook: shield not connected to GND
2026-10-15 First-light firmware patch for SDK 2.3.1, shifter power decision
2026-10-15 logbook: Pico 2 W runs our test build
2026-10-15 logbook: Pico pins in drawing checked against official pinout
2026-10-15 logbook: breadboard wired, continuity OK
2026-10-15 logbook: power-up check, press-fit header contact issue
    Claude-Session: https://claude.ai/code/session_01MZ3uQJCcn6FcjzVDhZnLJN
2026-10-15 First light: Game Boy <-> Pico 2 W <-> Mac, both directions, 0 errors in 1000 bytes
    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
2026-10-15 Breadboard drawing: direct wiring, no shifter
    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
2026-10-15 Printer emulator firmware, live Web Serial page, capture/render tools
    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
2026-10-15 Printer firmware: SCK glitch filter fixes crosstalk; printtest ROM; debug fixed-reply option
    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
2026-10-15 First print from a real Game Boy decoded to PNG
    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
2026-10-15 Hands-free print tool: double-click GB Printer.command, PNGs to ~/Pictures
    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
2026-10-15 Tools open only the Pico (USB vendor ID), never other serial devices
    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
2026-10-15 Print tool: non-blocking port reader (no reconnect loop), ioreg buffer fix, log file
    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
2026-10-15 README: full setup and printing instructions for others
    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
2026-10-15 Polished README with banner, wiring diagram, breadboard render, screenshots
    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
2026-10-15 Publish the web page and wiring drawing on GitHub Pages
    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
2026-10-15 PCB rev A: spec, part choice (JLC stock checked), RPi minimal design as base
    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
2026-10-15 PCB rev A schematic: RPi minimal core + Link sheet (USB-C, 5 V buffers, ESD, cable pads); ERC = RPi baseline, nets verified
    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
2026-10-15 Schematic: renumber Link parts to 101+ (clashed with RPi core refs)
    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
2026-10-15 PCB rev A routed: scripted build + Freerouting pipeline, DRC 0 errors
    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
2026-10-15 PCB rev A: DRC 0 errors/0 unconnected, silk cleaned, local RPi libs
    - TPD4E05U06 NC pins tied for straight-through routing (TI pin table)
    - bottom GND pour runs to the board edge (sealed island fix)
    - pcb_route retries Freerouting until DRC is clean
    - LCSC fields off silk, designators on fab, pad labels
    - extract_libs.py: RPi symbols/footprints + lib tables in the project
    - renders in hw/rev-a/img
    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
2026-10-15 PCB rev A: fix footprint library extraction, DRC 0 warnings
    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
2026-10-15 PCB rev A: JLC order files (BOM, CPL, Gerbers, pin audit), core LCSC parts
    Not ordered. Hold point: L1 (AOTA-B201610S3R3-101-T) has 4 in JLC stock.
    LED pad numbering fixed in the CPL (JLC A=1, KiCad K=1).
    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
2026-10-15 Firmware: per-board pin map (breadboard default, -DGBLINK_BOARD=revA for the PCB)
    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
2026-10-15 CLAUDE.md: PCB rev A status
    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
2026-10-15 PCB rev A: link simulation -> 220R + 100 pF, routing tidy-up, height check, Gerber render, hw README
    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
2026-10-15 Case for PCB rev A: OpenSCAD tray + lid, STLs, fit check (0 collision, mutation-tested)
    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
2026-10-15 PCB rev A: independent review fixes (R106 1k, longer board behind cable holes, USB-C flush, 16 MB flash, docs)
    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
2026-10-16 Order: 2 assembled boards; BOM check for 2, L1 stock note
    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
2026-10-17 Firmware: heartbeat calibration mode (internal exact 8192 Hz reference reads 0.00 ppm)
    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
2026-10-17 Firmware: re-align on every quiet gap, never block on the tx queue, flush stale bytes on bridge start, reset heartbeat sums on pin change
    From the robustness audit.
    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
